GentilTani/Distributeur-de-balle/README.md

# Electrogolf
Transporte les balles de golf de la réserve à la plateforme de tir
