GentilTani/Distributeur-de-balle/Rapports Séances/Rapports Swan/Rapport séance 7.pdf

GENTIL SWAN Peip2

## Electrogolf

Rapport Projet Arduino

Séance 21/02/2022

## I. Avancée de la conception

Pendant cette séance, la conception a été finalisé avec le placement du servomoteur à rotation continue permettant la mise en mouvement du bras. Nous avons rencontré quelques difficultés après la 1ère mise en place qui n’a pas tenu après un incident (placée au pistolet à colle).

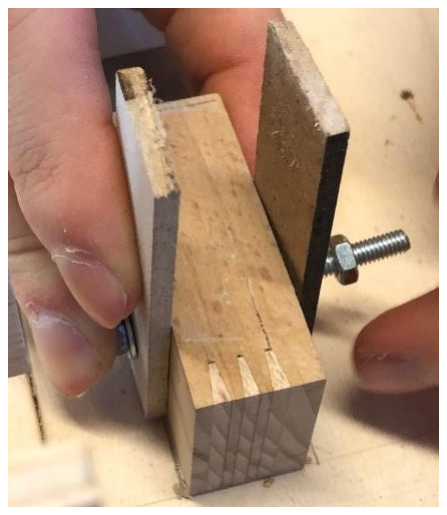
[picture p10: figure]

J’ai donc décidé de placer deux petites plaques de bois de part et d’autre du servomoteur et par ailleurs de laisser une liberté vers l’arrière. Cette liberté permettra au servomoteur de se retirer de l’engrenage s’il y a un blocage en amont.

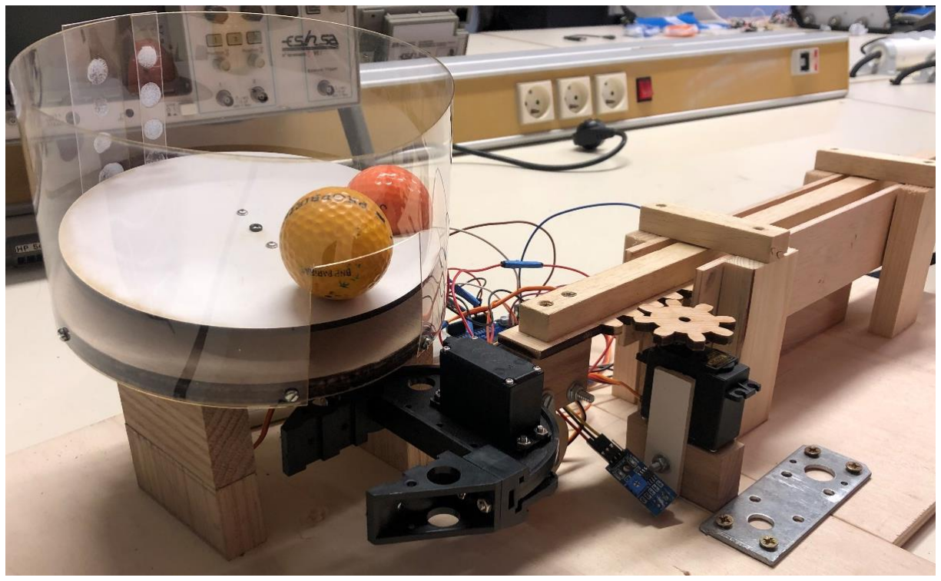
[picture p11: figure]

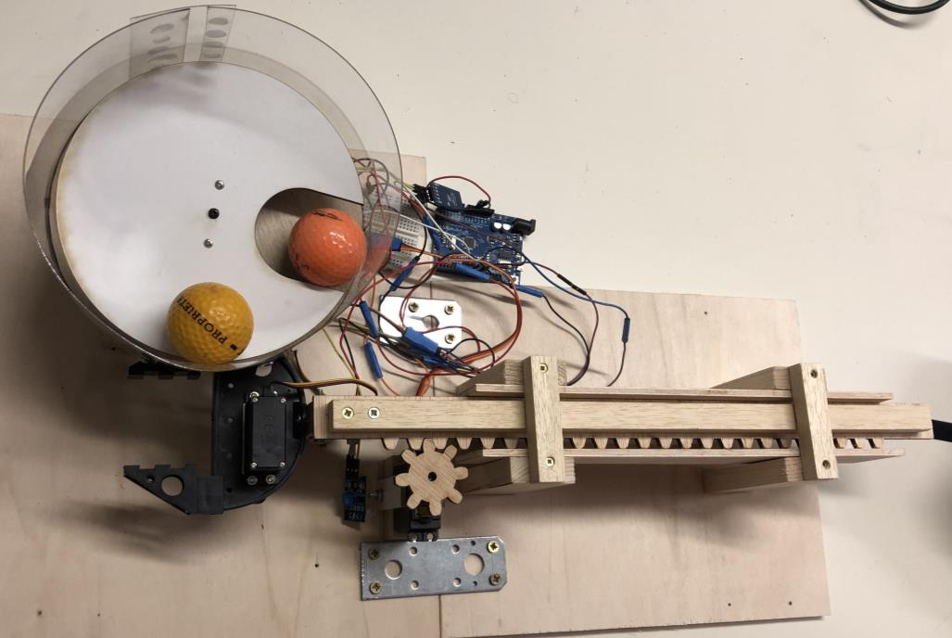
[picture p12: figure]

Le capteur est placé juste en dessous de la pince à l’aide de scotch.

Nous avons également branché tous les composants électroniques.

Il reste cependant une finalité qui devra être réalisé à la dernière séance. Nous allons devoir tenter de cacher le plus possible la carte Arduino (aspect purement esthétique) et d’organiser les fils électriques pour pas qu’il gène le mouvement du bras et se placent en dessous de la roue.

## II. Avancée du code

Nous avons avancé l’aspect élétrocnique en dehors des séances et nous avons réussi à faire fonctionner chaque composant à l’aide de l’application Bluetooth sur téléphone.

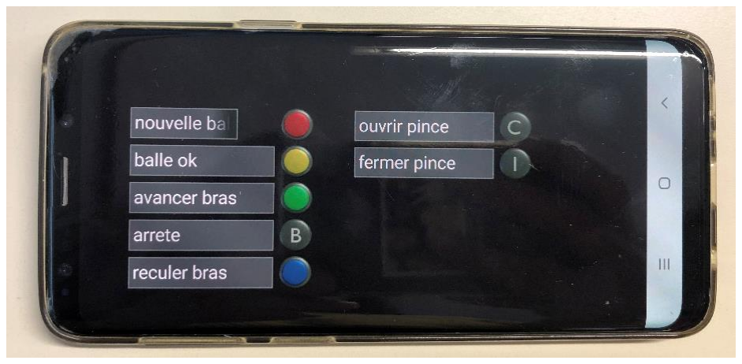
[picture p13: figure]

Cette séance nous avons donc également finalisé le montage ainsi que les problèmes du code : problème concernant le capteur.

Le problème de capteur était le suivant : celui-ci ne captait pas en permanence mais qu’une seule fois. La raison est qu’il était inclus dans le « if » du Bluetooth available. If qui est tout le temps vrai lorsque l’on est connecté en Bluetooth avec le téléphone. Il a donc fallu sortir le code du capteur de cette boucle car celui-ci est indépendant du Bluetooth.

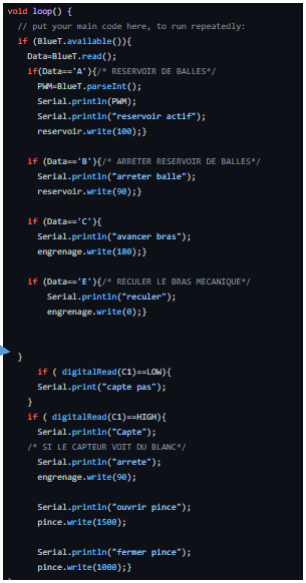
[picture p14: figure]

Fin du « if »
concernant le
Bluetooth
