GentilTani/Distributeur-de-balle/Rapports Séances/Rapports Swan/Rapport séance 5.pdf

GENTIL SWAN Peip2
Electrogolf

Rapport Projet Arduino

Séance 31/01/2022

I. Avancée de la conception

J’ai décidé d’avancer la conception du projet en attendant la mise au point du Bluetooth. Ainsi, j’ai choisi une grande plaque en bois en guise de support (environ 60cm par 40). Ensuite, j’ai visé trois petites planches de bois pour soutenir le réservoir et éviter qu’il ne prenne appui que sur le servomoteur. J’ai due préalablement percé la planche pour faciliter le visage.

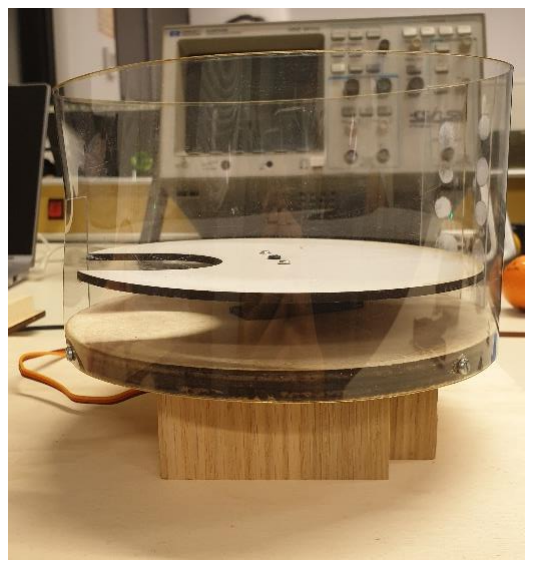
[picture p15: figure]
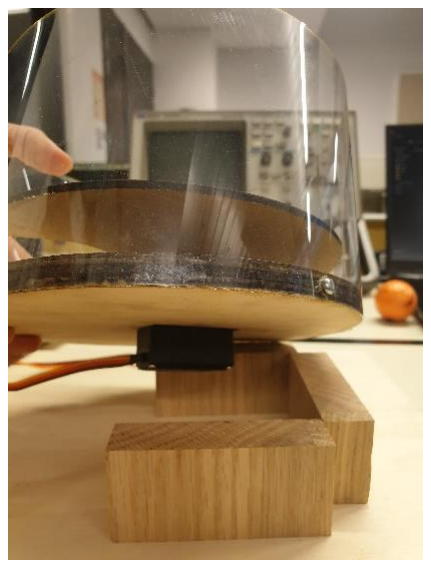
[picture p16: figure]

En deuxième temps, j’ai décidé de coller notre roue dentée à une pièce en étoile du servomoteur pour pouvoir actionner nos engrenages. Puis toujours en rapport avec notre bras avec engrenage, j’ai visé une tige en bois pour rigidifier le bras qui jusque-là ne supportait pas le poids de la pince.

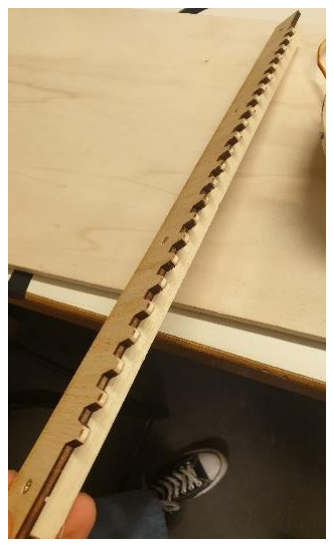
[picture p17: figure]
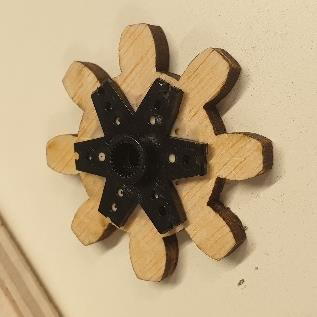
[picture p18: figure]

II. Avancée du code

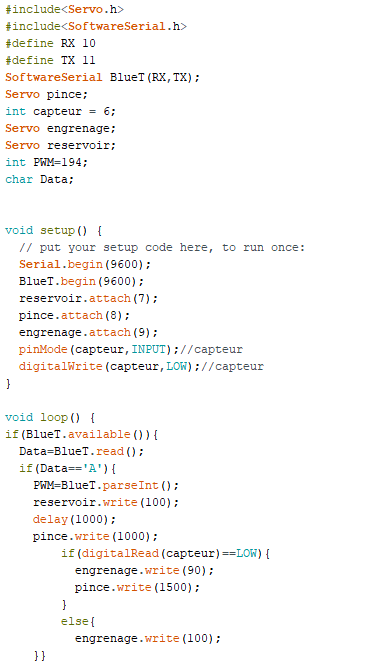
[picture p19: figure]

Une fois ma conception terminée, Le Bluetooth avait été mis au point. Nous avons donc pu l’intégrer dans le code principal de l’Electrogolf avec succès !

Pour l’instant la communication carte arduino-téléphone fonctionne et nous arrivons à activer nos différents composants à l’exception du capteur qui n’agit pas dans les « if » du code cicontre.

Il a fallu insérer une nouvelle librairie en début de code : <SoftwareSerial.h>.

Deux autres sorties/entrées digital ont dû être utilisées pour permettre la communication entre le module Bluetooth de la carte arduino et le téléphone: 10 et 11.

III. Séance à venir

Pour la prochaine séance, je devrai relever et incliner le réservoir car malgré mes ajouts de plaquettes en bois, celui-ci reste trop bas par rapport au bras . L’inclinaison permettra à la balle de tomber plus facilement vers la pince. J’ajouterai donc deux triangles en bois pour soutenir le tout.

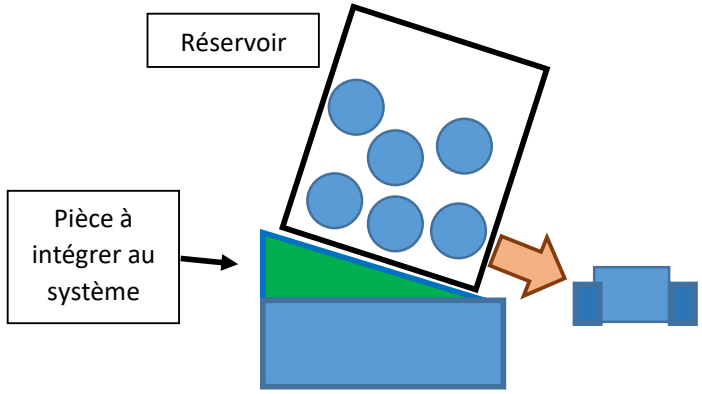
[picture p20: figure]
Pièce à intégrer au système; Réservoir

Pince
