GentilTani/Distributeur-de-balle/Rapports Séances/Rapports Lilou/RS 03.01.2022 TANI LILOU.pdf

TANI Lilou Peip2

# RAPPORT DE SEANCE N°3

(03.01.22)

OBJECTIFS DE LA SEANCE

L’objectif de cette séance était de :

- Créer les pièces de la maquette au FAB LAB et les assembler
- Continuer de faire le programme qui actionne tous les mécanismes à la suite
- Commencer à s’occuper du système Bluetooth

REALISATION DURANT LA SEANCE

Le matin de la séance, nous sommes allés au FAB LAB dans l’objectif de découper nos pièces au laser. Pour ceci nous avons utilisé le site Inkscape Pour créer trois pièces (deux en bois et une en polycarbonate).

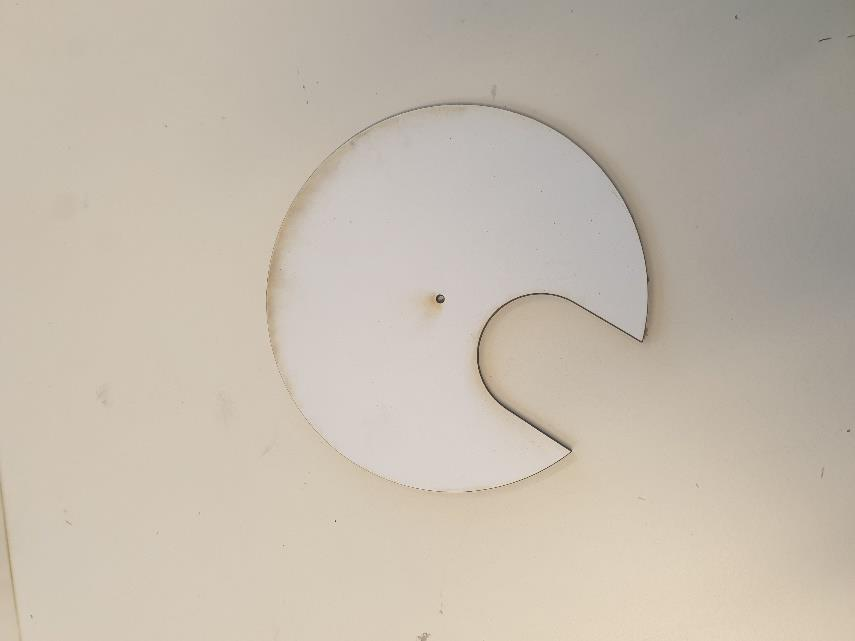
[picture p21: figure]
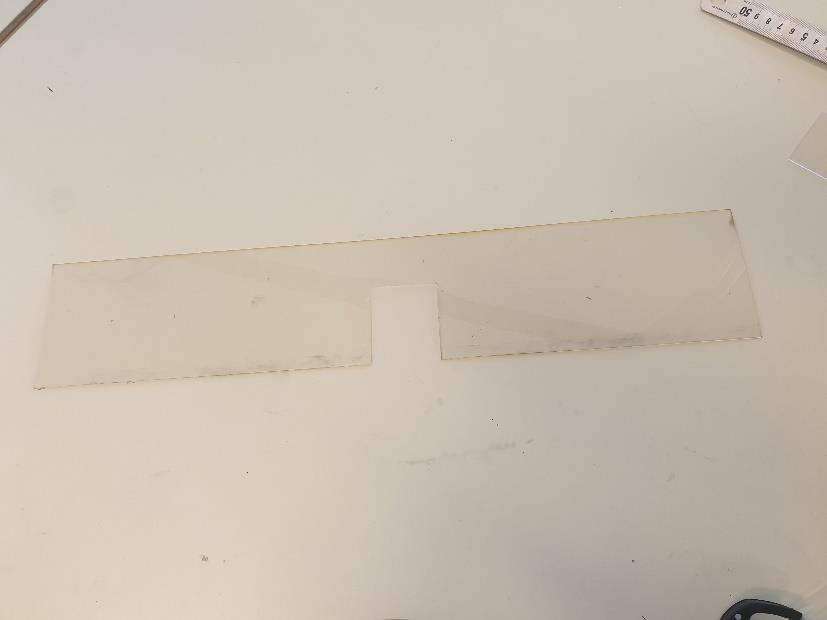
[picture p22: figure]

Contour du réservoir de balles | Sélectionneur de balles

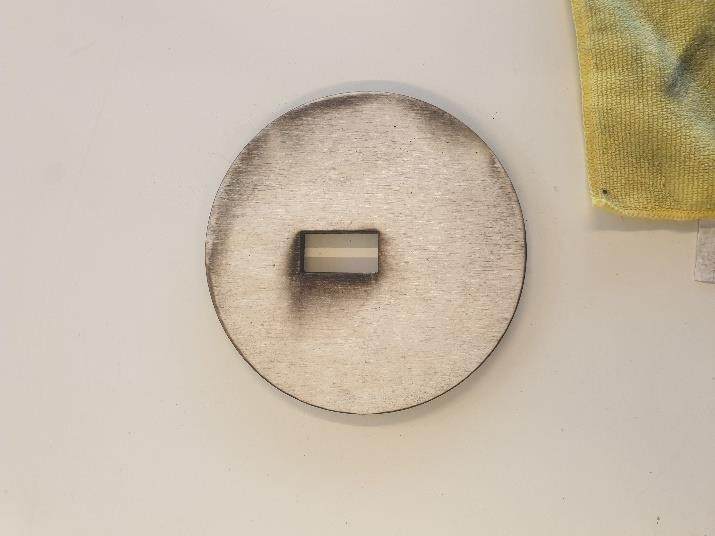
[picture p23: figure]

Fond du réservoir à balles

Par rapport aux modélisations que j’avais faites la seule forme qui change est celle du fond de réservoir : un rectangle a été ajouté pour faire passer le servomoteur à rotation continue et le visser directement au réservoir de balles.

## Pendant la moitié de la séance nous avons donc assemblé toutes ses pièces :

- D’abord, nous avons collé les bouts du contour du réservoir de balles que nous avions fait trop petit en longueur avec de la colle forte.

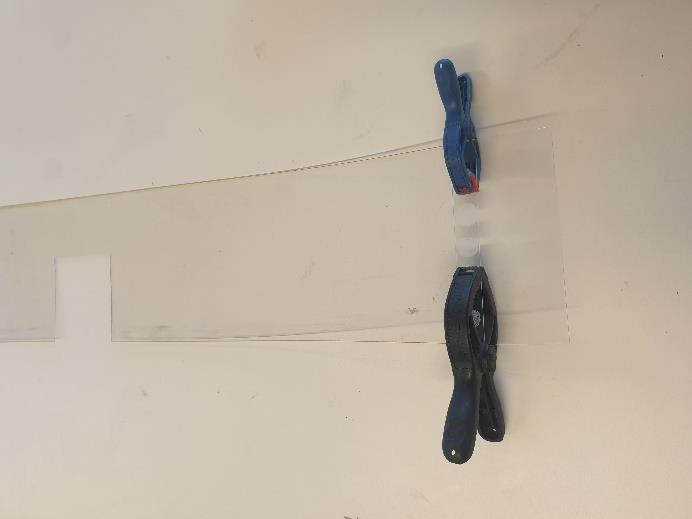
[picture p24: figure]

- Ensuite nous avons d’une part vissé le servomoteur au sélectionneur de balles et d’autre part le contour du réservoir au fond du réservoir.

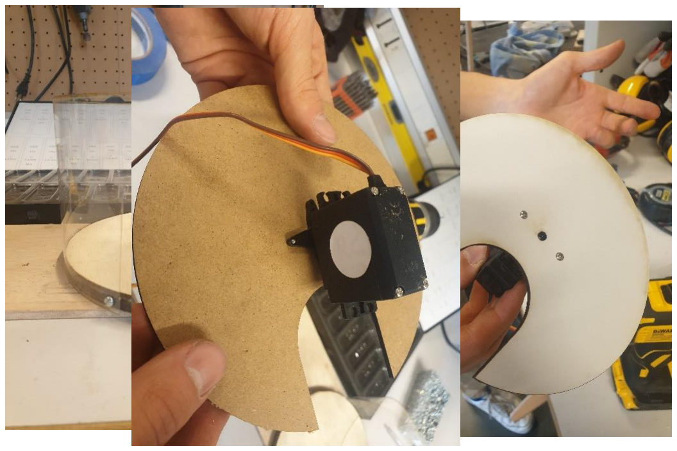
[picture p25: figure]

## Après ceci, je me suis mise à la partie Bluetooth :

Avec les cours de M. MASSON j’ai commencé un programme comme celui que nous avions réalisé :

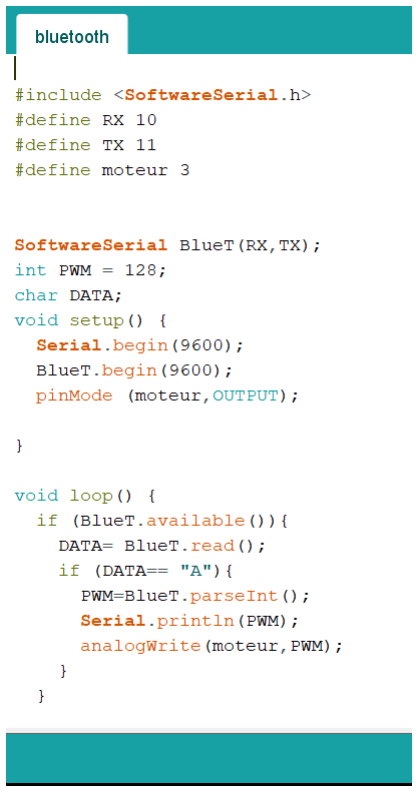
[picture p26: figure]

Après ceci M. MASSON | m’a conseillé d’utiliser le
site MIT App Inventor | que je n’ai pas eu le
temps de découvrir pleinement pour commencer un programme.

Une vidéo qui montre tous les mécanismes qui s’activent grâce au capteur est disponible sur GitHub dans le dossier « Vidéos ».
