GentilTani/Distributeur-de-balle/ELECTROGOLF DIAPO GENTIL TANI.pdf

# ELECTROGOLF

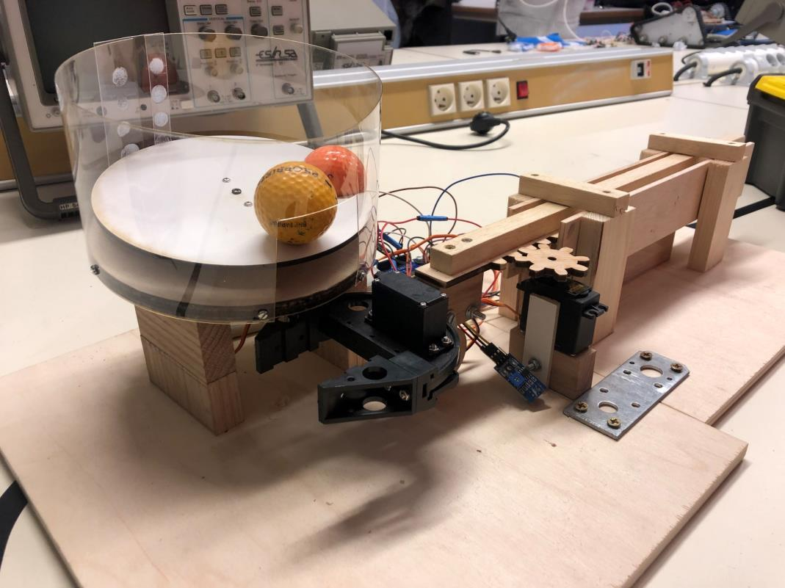
[picture p39: figure]

### TANI Lilou – GENTIL Swan - Peip2 - Groupe 1

### - Objectif du projet

### - Comment il fonctionne ?

### - Déroulement de la création du projet : - Partie programmation - Partie conception

### - Conclusion

# OBJECTIF DU PROJET

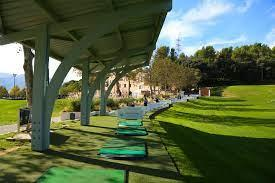
[picture p40: figure]

### - Simplifier la pratique du golf

### - Facilité de progression

### - Maximiser temps de pratique

# FONCTIONNEMENT

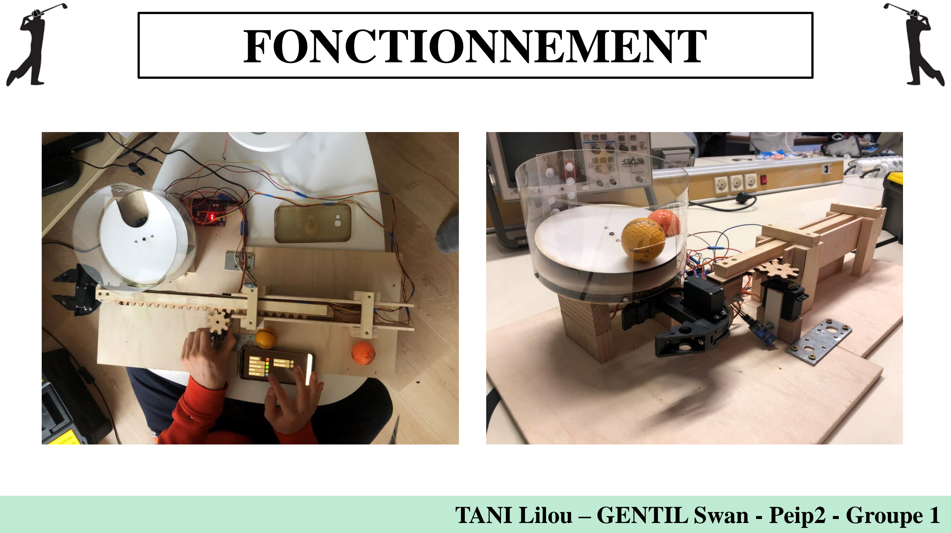
[picture p41: page 3]

# PROGRAMMATION

Sélectionner la balle (servomoteur à rotation continue)

Avancer le bras (servomoteur à rotation continue)

Blanc | Noir

Arrêter le bras

Pince fermée | Pince ouverte

Reculer le bras

Arrêter le bras

Capteur voit-il du blanc ou du noir ?

### Servomoteurs à rotation continue

### Servomoteur (pince)

### Capteur

### Bluetooth

# PROGRAMMATION

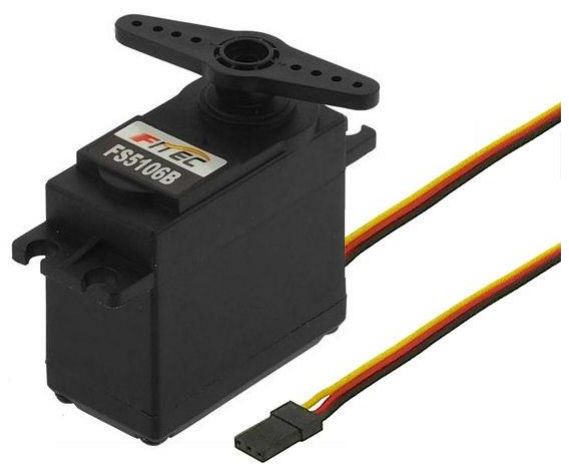
[picture p42: figure]

### Moteur RC (rotation continue) :

Librairie Servo.h
Servo variable
variable.attach(1-9)
variable.write(0-180)

Variation de la vitesse de rotation

### Servomoteur :

Librairie Servo.h
Servo variable
variable.attach(1-9)
variable.write(544-2400)

Obtenir un angle
Vitesse inchangée

# PROGRAMMATION

### Capteur IR :

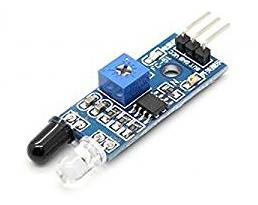
[picture p43: figure]

pinMode(entrée analogique, INPUT) digitalRead(entrée analogique) = = « LOW » ou « HIGH »

### Bluetooth :

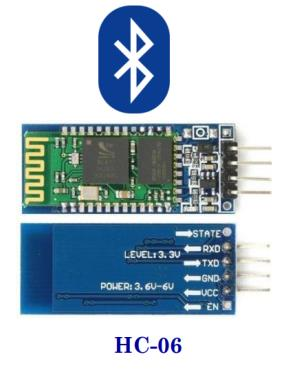
[picture p44: figure]

Librairie SoftwareSerial
Borne RX (réception) et TX(transmission) Lecture d’information de l’application vers la puce

# CONCEPTION

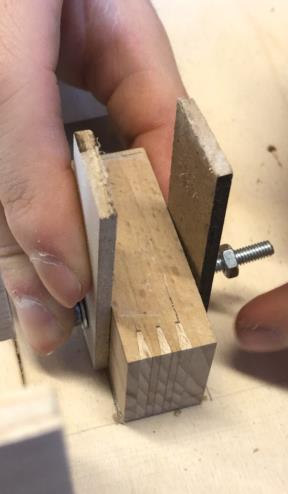
[picture p45: figure]
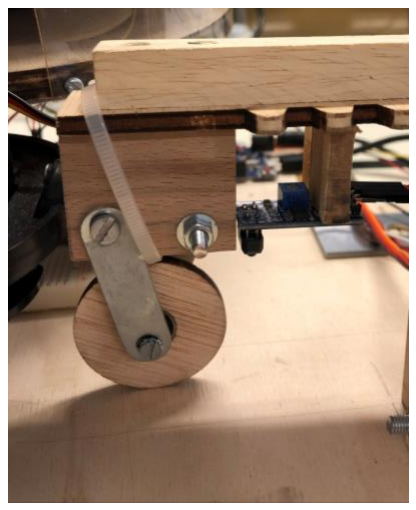
[picture p46: figure]
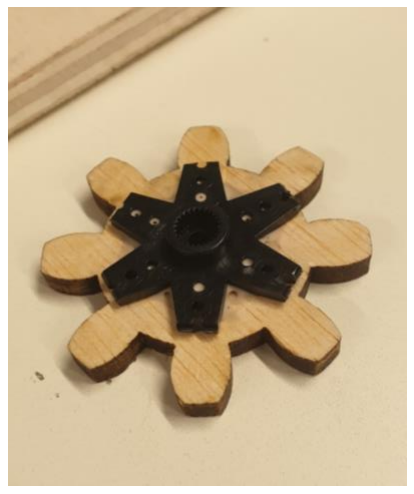
[picture p47: figure]

### Bras mécanique :

- Pince/Servomoteur
- Engrenages
- Capteur IR
- Roue
- Servomoteur RC

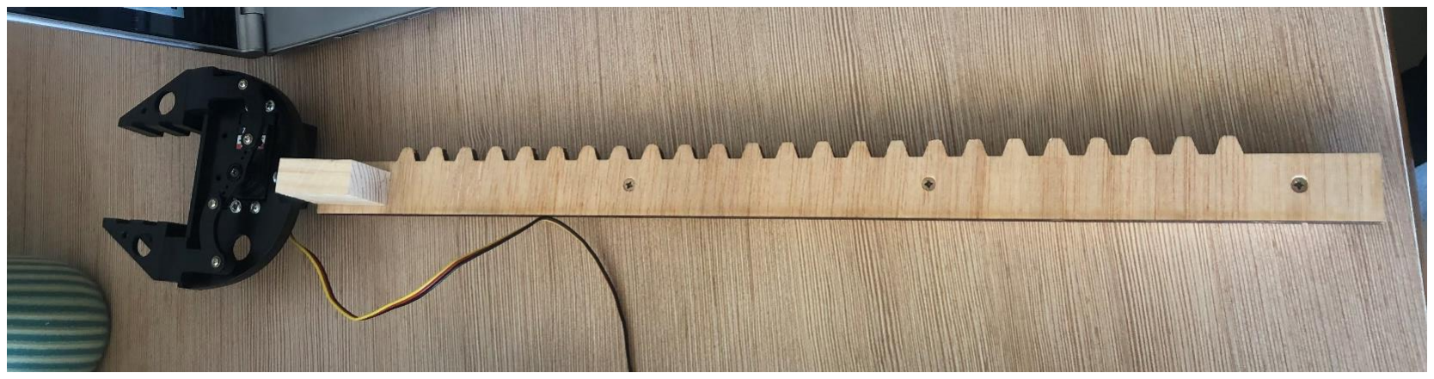
[picture p48: figure]

Economie/écologie

# CONCEPTION

### Réservoir cylindrique :

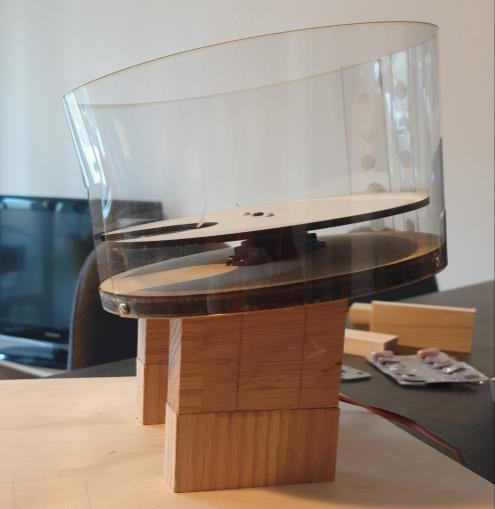
[picture p49: figure]
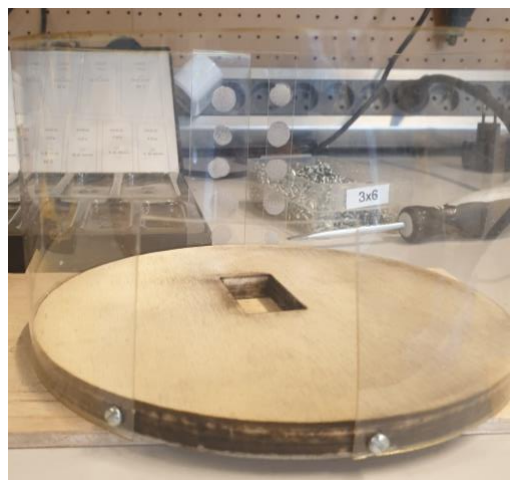
[picture p50: figure]
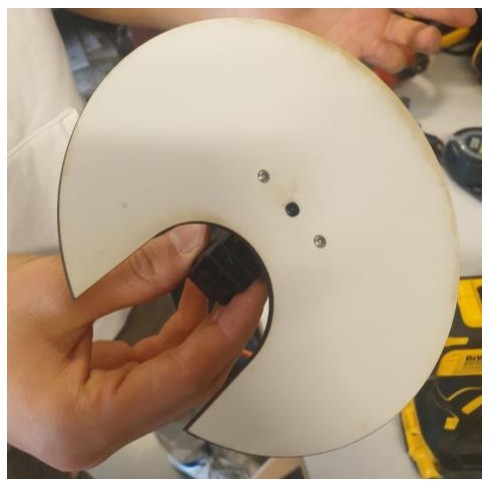
[picture p51: figure]

- Paroi polycarbonate (plastique)
- Pièce circulaire indépendante
- Planche circulaire
- Servomoteur RC
- Socle incliné

Economie/écologie

# CONCLUSION

### Si nous avions plus de temps:

### - Automatiser encore plus le système - Maintient du capteur suffisamment proche du sol - Frottement du bras contre le support/coincement des fils

### Apports du projet :

### - Meilleure organisation des tâches - Travail avec une deadline - Faire face aux difficultés
