GentilTani/Distributeur-de-balle/Rapports Séances/Rapports Lilou/RS 31.01.2021 TANI LILOU .pdf

TANI Lilou Peip2

## RAPPORT DE SEANCE N°5

(31.01.22)

OBJECTIFS DE LA SEANCE

L’objectif de cette séance était de :

- Terminer le module Bluetooth ;
- Fixer la maquette sur une planche et s’occuper du « bras ».

REALISATION DURANT LA SEANCE

Durant cette séance, j’ai continué à écrire le code pour connecter la puce Arduino au téléphone. J’ai essayé de faire marcher mon code avec l’application MIT mais cela n’a pas fonctionné donc j’ai tenté avec l’application Bluetooth Electronics :

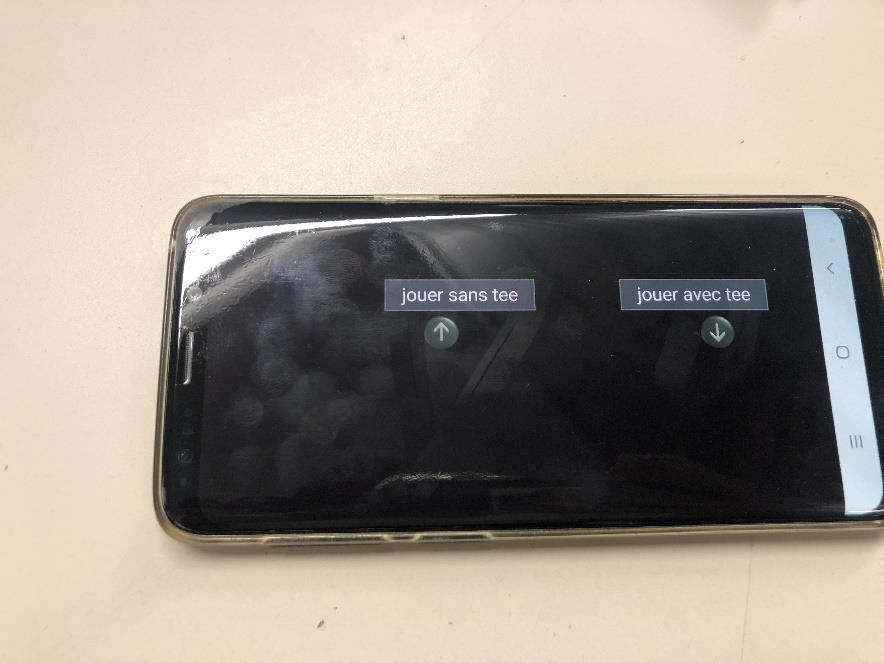
[picture p74: figure]

Le design n’est pas très élaboré pour le moment car je souhaite faire en sorte que tout marche avant de m’avancer dans cette application.

J’ai donc repris les codes que nous avions réalisé pour cette application en prenant en compte qu’il y a dans notre projet deux cas (sans tee et avec tee) :

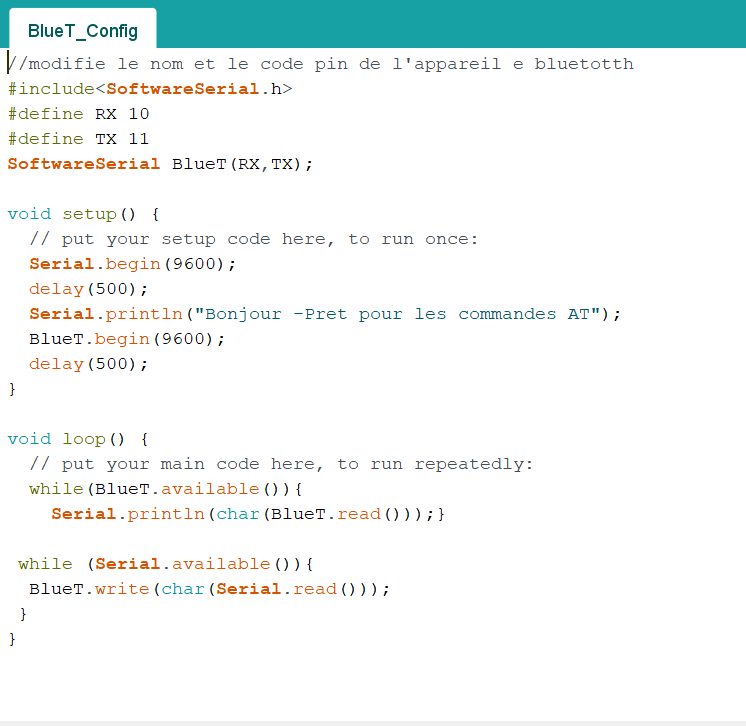
[picture p75: figure]

Programme pour configurer la puce Bluetooth HC-06 (nous n’avons pas encore donné un nom à notre puce ni configuré le mot de passe, nous le ferons quand tout fonctionnera)

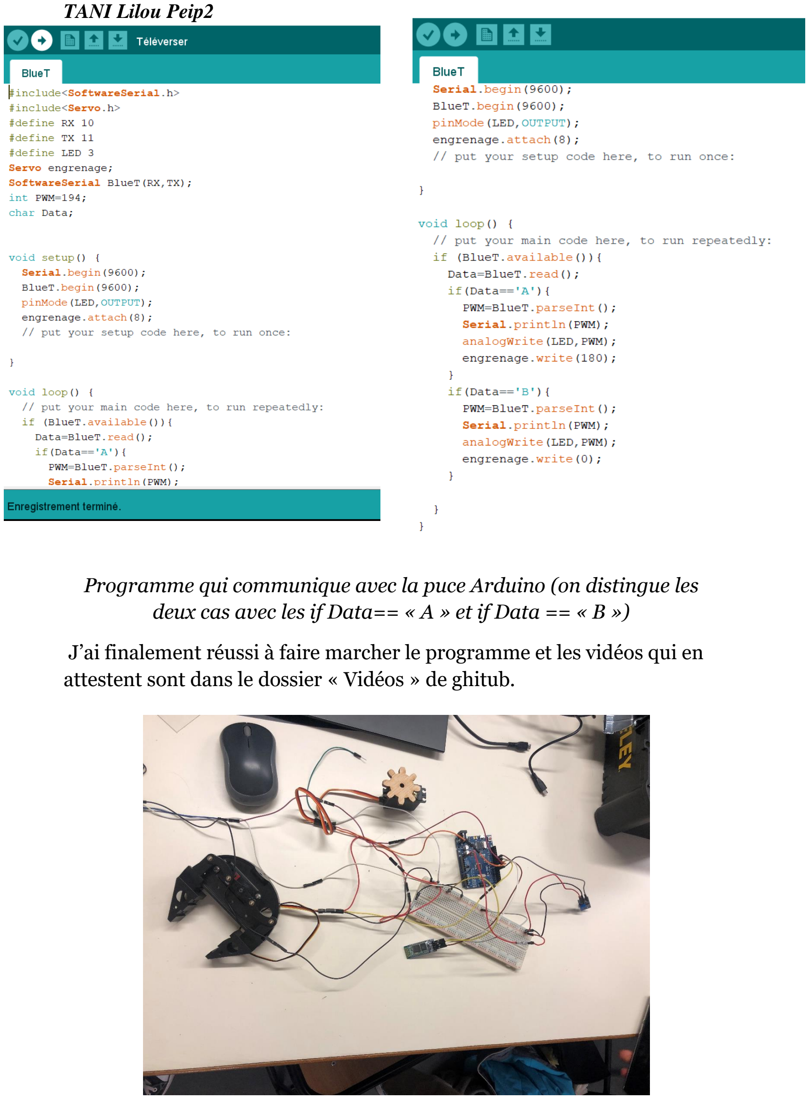
[picture p76: page 3]

Programme qui communique avec la puce Arduino (on distingue les deux cas avec les if Data== « A » et if Data == « B »)

J’ai finalement réussi à faire marcher le programme et les vidéos qui en attestent sont dans le dossier « Vidéos » de ghitub.
