GentilTani/Distributeur-de-balle/Rapports Séances/Rapports Swan/Rapport séance 4.pdf

GENTIL SWAN Peip2
Electrogolf

Rapport Projet Arduino

Séance 10/01/2022

I. Avancée du code

En attendant l’avancée du Bluetooth du côté de ma partenaire, j’ai essayé de décortiquer un maximum l’algorithme du programme final.

J’ai donc réalisé un organigramme du code pour pouvoir comprendre vers où me diriger et me raccrocher à celui-ci lorsque des erreurs interviendront.

Vous trouverez l’organigramme en fin de rapport.

Le code du loop est en commentaire car la partie bluetooth n’est pas encore opérationnelle.

De plus, une avancée au niveau de la conception du support et du bras amovible faciliterait les essaies et les tests opérés sur le code.

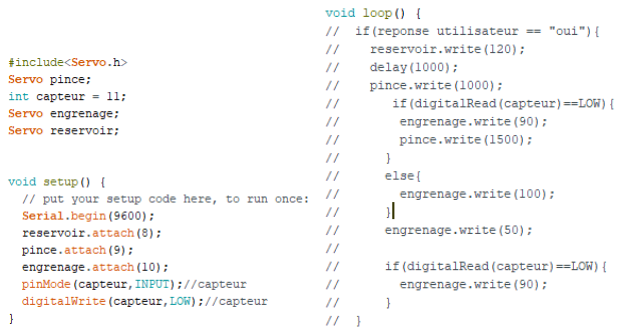
[picture p79: figure]

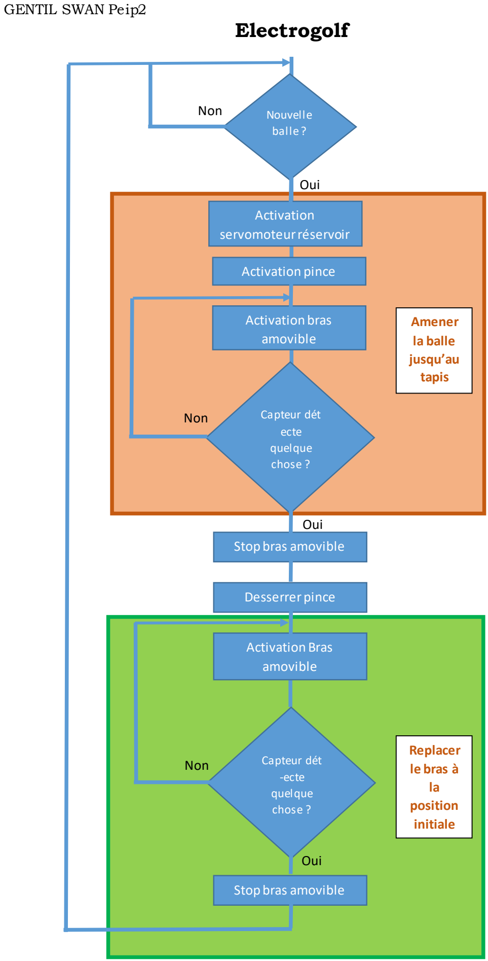
[picture p80: figure]
GENTIL SWAN Peip2; Electrogolf; Nouvelle balle?; Activation servomoteur réservoir; Activation pince; Capteur dét ecte quelque chose ?; Activation bras amovible; Stop bras amovible; Desserrerpince; Activation Bras amovible; Capteur dét -ecte quelque chose ?; Oui; Non; Amener la balle jusqu’au tapis; Replacer le bras à la position initiale
