GentilTani/Distributeur-de-balle/Code/BlueT_Config.ino

//modifie le nom et le code pin de l'appareil e bluetotth
#include<SoftwareSerial.h>
#define RX 10
#define TX 11
SoftwareSerial BlueT(RX,TX);

void setup() {
  // put your setup code here, to run once:
  Serial.begin(9600);
  delay(500);
  Serial.println("Bonjour -Pret pour les commandes AT");
  BlueT.begin(9600);
  delay(500);
}

void loop() {
  // put your main code here, to run repeatedly:
  while(BlueT.available()){
    Serial.print(char(BlueT.read()));}
    
 while (Serial.available()){
  BlueT.write(char(Serial.read()));
 }
}
